ab0tj/dabao/README.md

# dabao

打包 (dǎ bāo or daa2 baau1), which means to take out (food) in Chinese, is a wireless, portable 36-key keyboard with a thumb trackpoint, designed for maximum flexibility and convenience.

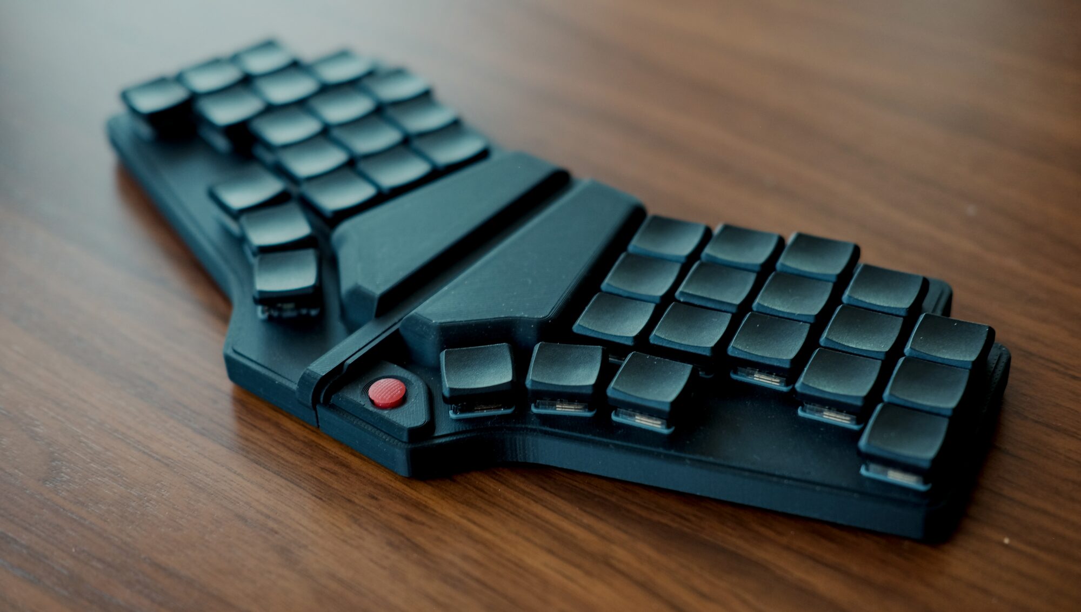
[picture p1: images/DSCF3942-web.jpg]
pcb as unibody
> 
> <sub>Keyboard can be used as a unibody...</sub>
>
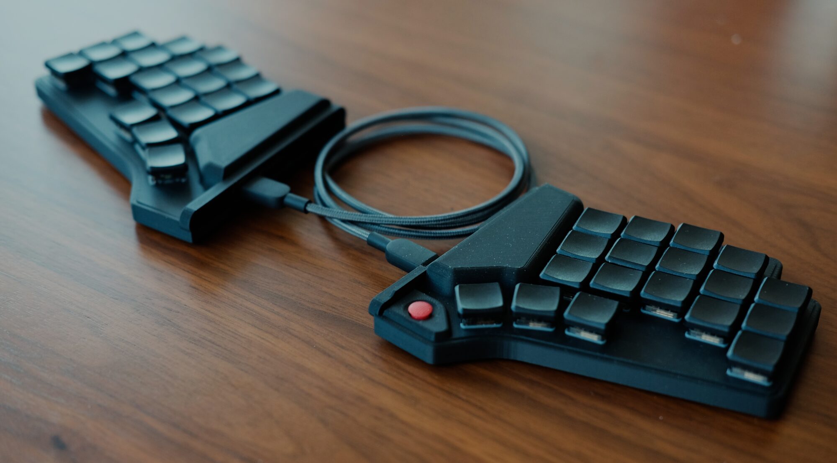
[picture p2: images/DSCF3957-web.jpg]
pcb as split
> 
> <sub>... or as a split!</sub>

## Design Rationale

I found that split keyboards can be cumbersome when I’m not working at a desk. Managing a laptop plus two independent keyboard halves while moving between coworking spaces, cafés, or even working from the couch quickly becomes unwieldy, and thus began the journey to create a keyboard for this specific need...

This project explores a keyboard that can seamlessly switch between a unibody form factor (easy to pick up and carry) and a fully split configuration when there's space for a full ergonomic setup. An integrated pointing device is included to reduce the need for external peripherals, making it truly portable.

Albeit unconventional, the trackpoint is positioned under the thumb to:

- Enable the use of hotswap sockets while keeping the overall keyboard height low
- Eliminate the need to modify keycaps for trackpoint clearance
- Allow the fingers to remain on the home row during pointing tasks

In practice, using the thumb instead of the index finger feels functionally similar. After a short adjustment period, I personally haven't experienced a meaningful loss in accuracy or precision.

## Features

- **Unibody or Split:** Unique magnetic 4-pin connector allows the keyboard to be used as a single unibody or split into two halves via a USB-C cable. Use unibody mode on the go, and split mode at your desk!
- **Single Microcontroller:** Uses one microcontroller and a GPIO expander, eliminating the need for two controllers or batteries to simplify charging and reduce costs.
- **Integrated Trackpoint:** For convenient and precise cursor control.
- **Reversible PCB:** Keeps ordering PCBs affordable.
- **Wireless via Bluetooth:** Wireless operation (between the host computer) for portability.
- **Hotswap Switches:** Supports Choc V1 or V2 switches. Can also be soldered directly if desired.
- **Thin:** The case measures a mere 8mm from top to bottom (excluding switches and keycaps), making it very portable.

## Case

The case was designed to be 3D printed with FDM in PLA or similar material, making it easy to print at home with consumer grade printers. Multi-material would be useful for cleaner removal of supports, but is not necessary. The case as shown was printed in Charcoal Black Matte PLA on a BambuLab P1S (no AMS).

See [here](./cad) for CAD files, and printing instructions [here](./docs/build-guide.md#case).

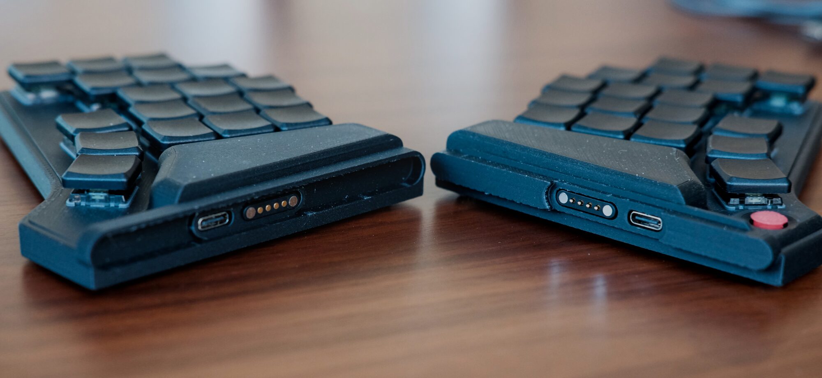
[picture p3: images/DSCF3886-web.jpg]


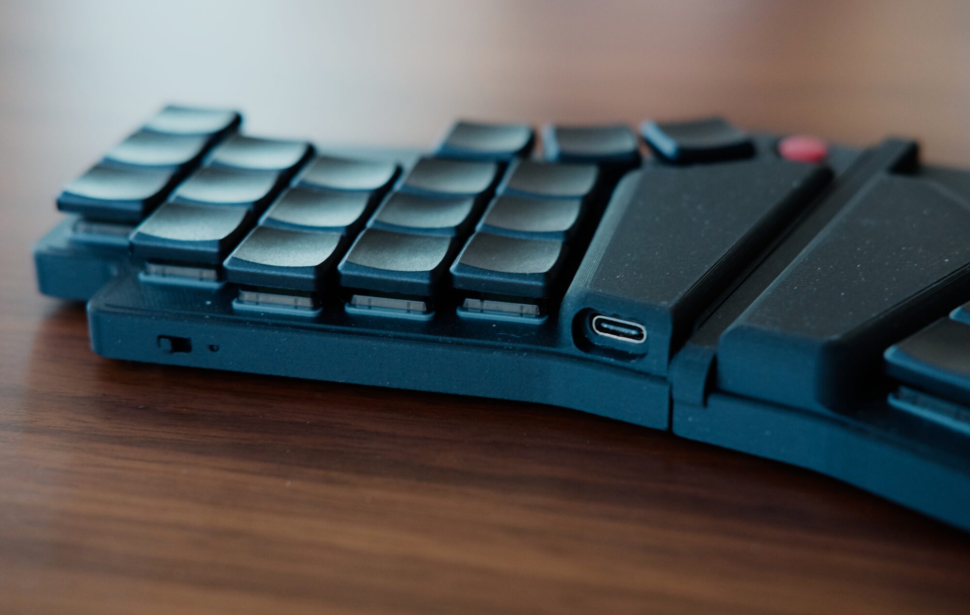
[picture p4: images/DSCF3946-web.jpg]


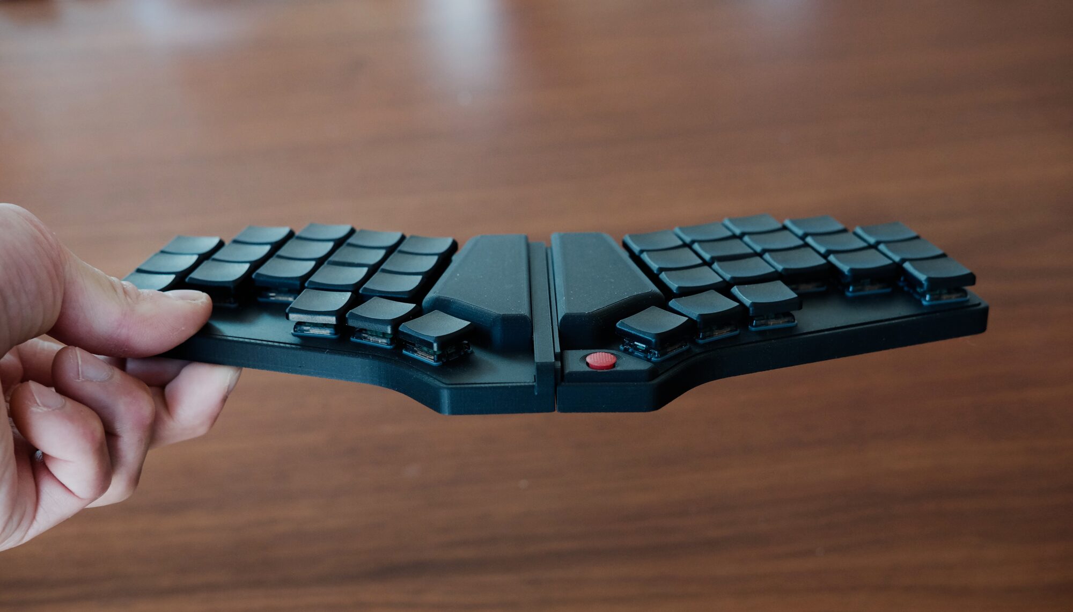
[picture p5: images/DSCF3984-web.jpg]


## Build Guide

> [!WARNING]
> This project is provided for educational and experimental purposes only. It is shared "as-is," without any warranty of any kind, express or implied, including but not limited to the warranties of merchantability or fitness for a particular purpose. By using these files, you acknowledge that you are assuming all risks associated with the assembly, use, and operation of the hardware. The author shall not be liable for any claim, damages, or other liability, whether in an action of contract, tort, or otherwise, arising from, out of, or in connection with the project or the use of these files.

See [Build Guide](./docs/build-guide.md) for instructions on how to build one for yourself!

## Firmware

See [zmk-config](https://github.com/justinmklam/zmk-config).

## Acknowledgements

This design was inspired by the following keyboards:

- [TPS42](https://github.com/crehmann/TPS42)
- [duet](https://github.com/zzeneg/duet)
- [Santoku](https://www.reddit.com/r/ErgoMechKeyboards/comments/oisnad/i_made_this_santoku_gen_2_trackpoint_as_a/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)

Helpful trackpoint resources:

- [infused-kim's Trackpoint Driver](https://github.com/infused-kim/kb_zmk_ps2_mouse_trackpoint_driver) - outdated for the recent versions of zmk, but still a treasure trove of information
- [Jorne Trackpoint Wiki](https://github.com/joric/jorne/wiki/Tracking)
- [TheMK Wiki - TrackPoint Overview](https://wiki.themk.org/index.php/TrackPoint)
- [KBD News - Trackpoint Integration Guide](https://kbd.news/How-to-integrate-a-trackpoint-into-your-keyboard-2447.html)
- [r/Trackpoint_Builders](https://www.reddit.com/r/TrackPoint_Builders/)
- [Trackpoint Builders Discord](https://discord.gg/48gM4jZkW)

## Support

Thank you to my sponsors for making this project possible!

The PCBs for this project were manufactured by **[PCBWay](https://pcbway.com)**. The boards came out clean with good tolerances and had a fast turnaround, especially considering it came from the other side of the world. Recommended if you're looking to prototype or build your own keyboard!
