ab0tj/dabao/docs/images/pasted-image-20261012104052.png

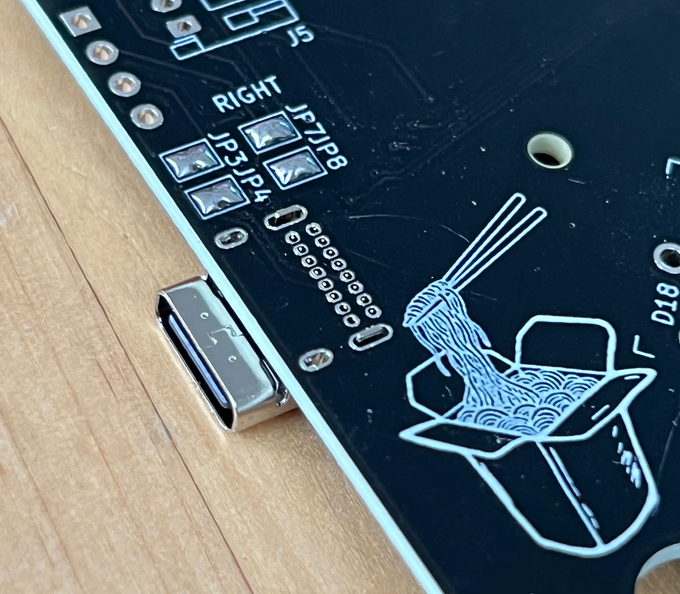
docs/images/pasted-image-20261012104052.png
