ab0tj/dabao/docs/images/pasted-image-20261012104239.png

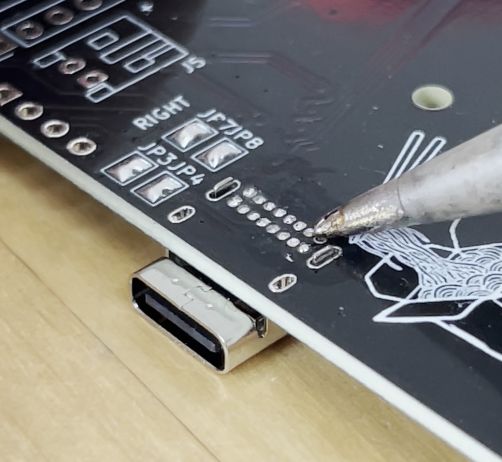
docs/images/pasted-image-20261012104239.png
