ab0tj/dabao/cad/3dprint/Right Bottom.stl

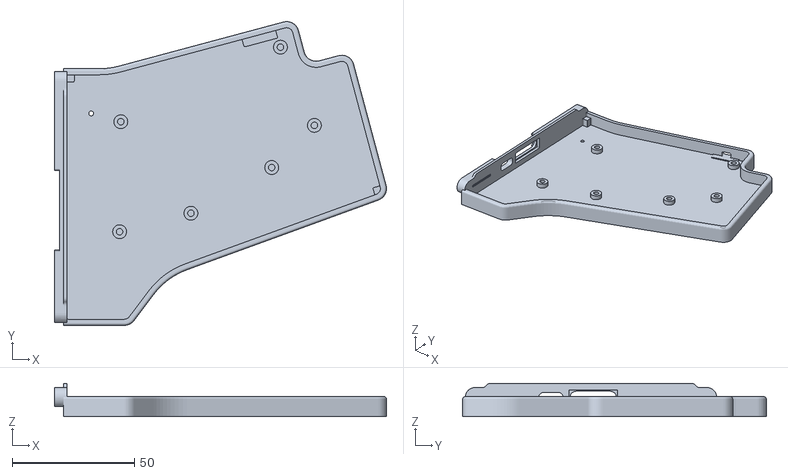
[picture p9: CAD file, 2026-10-15]
cad/3dprint/Right Bottom.stl
135.8 x 124.2 x 13.7
