ab0tj/dabao/cad/case.step

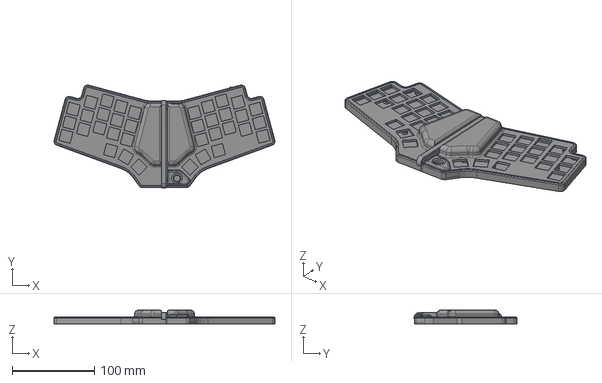
[picture p10: CAD file, 2026-10-15]
cad/case.step
268.1 x 124.9 x 17.0 mm
