ab0tj/dabao/cad/dabao.step

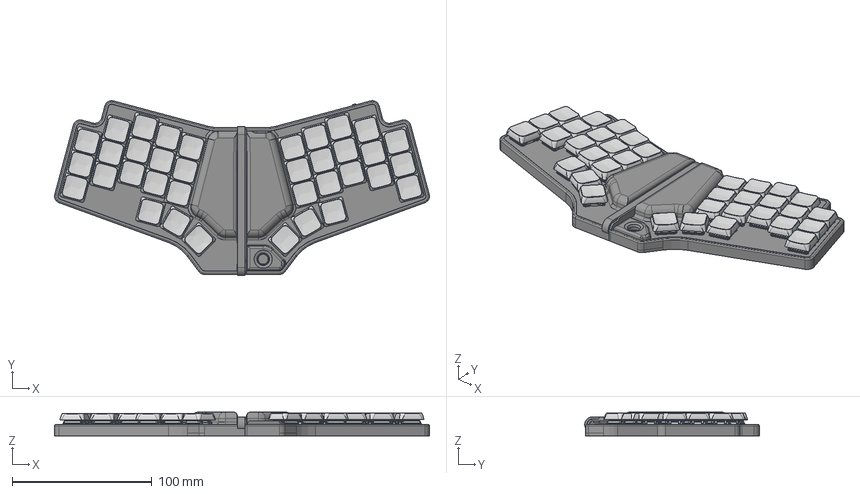
[picture p12: CAD file, 2026-10-15]
cad/dabao.step
268.1 x 124.9 x 17.0 mm
