ab0tj/dabao/cad/3dprint/Right Top.stl

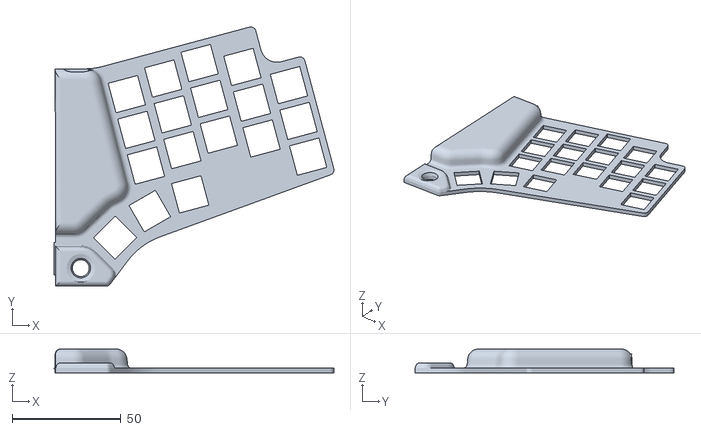
[picture p13: CAD file, 2026-10-15]
cad/3dprint/Right Top.stl
128.6 x 119.0 x 11.0
