ab0tj/dabao/cad/3dprint/Left Bottom.stl

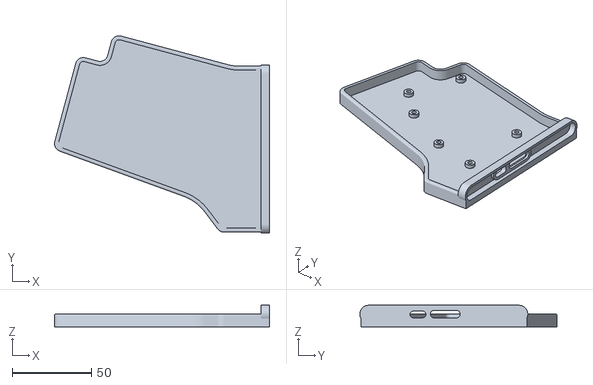
[picture p14: CAD file, 2026-10-15]
cad/3dprint/Left Bottom.stl
136.0 x 124.9 x 13.7
