ab0tj/dabao/cad/3dprint/Power Switch.stl

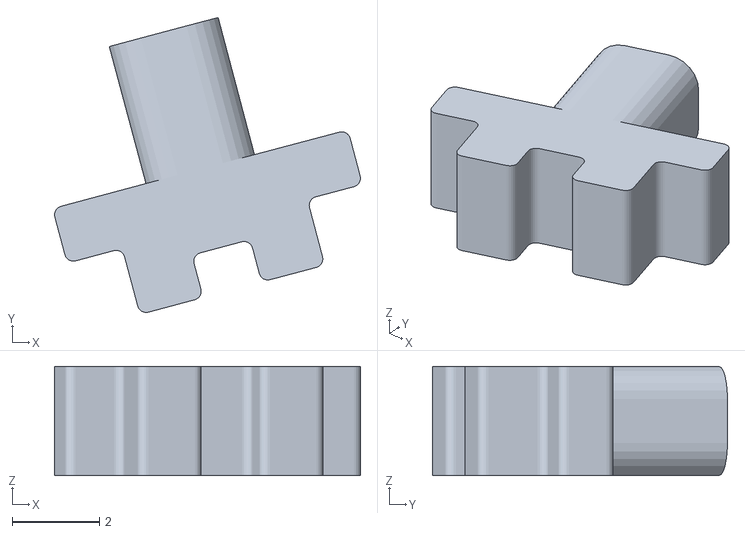
[picture p15: CAD file, 2026-10-15]
cad/3dprint/Power Switch.stl
7.01 x 6.76 x 2.50
