ab0tj/dabao/cad/3dprint/Trackpoint Stem Multi.stl

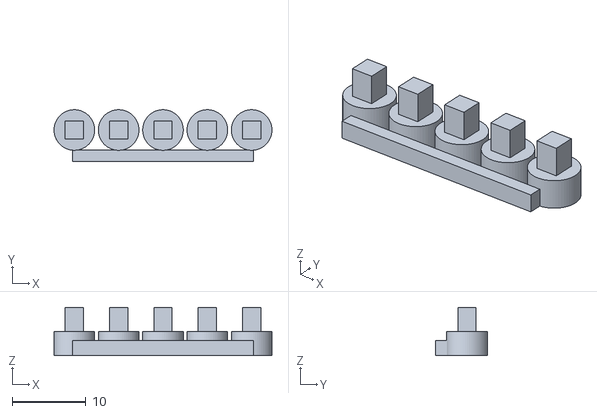
[picture p16: CAD file, 2026-10-15]
cad/3dprint/Trackpoint Stem Multi.stl
29.5 x 6.98 x 6.50
