ab0tj/dabao/pcb/dabao/dabao.kicad_pcb

## KiCad design pcb/dabao/dabao.kicad_pcb (2026-10-16)

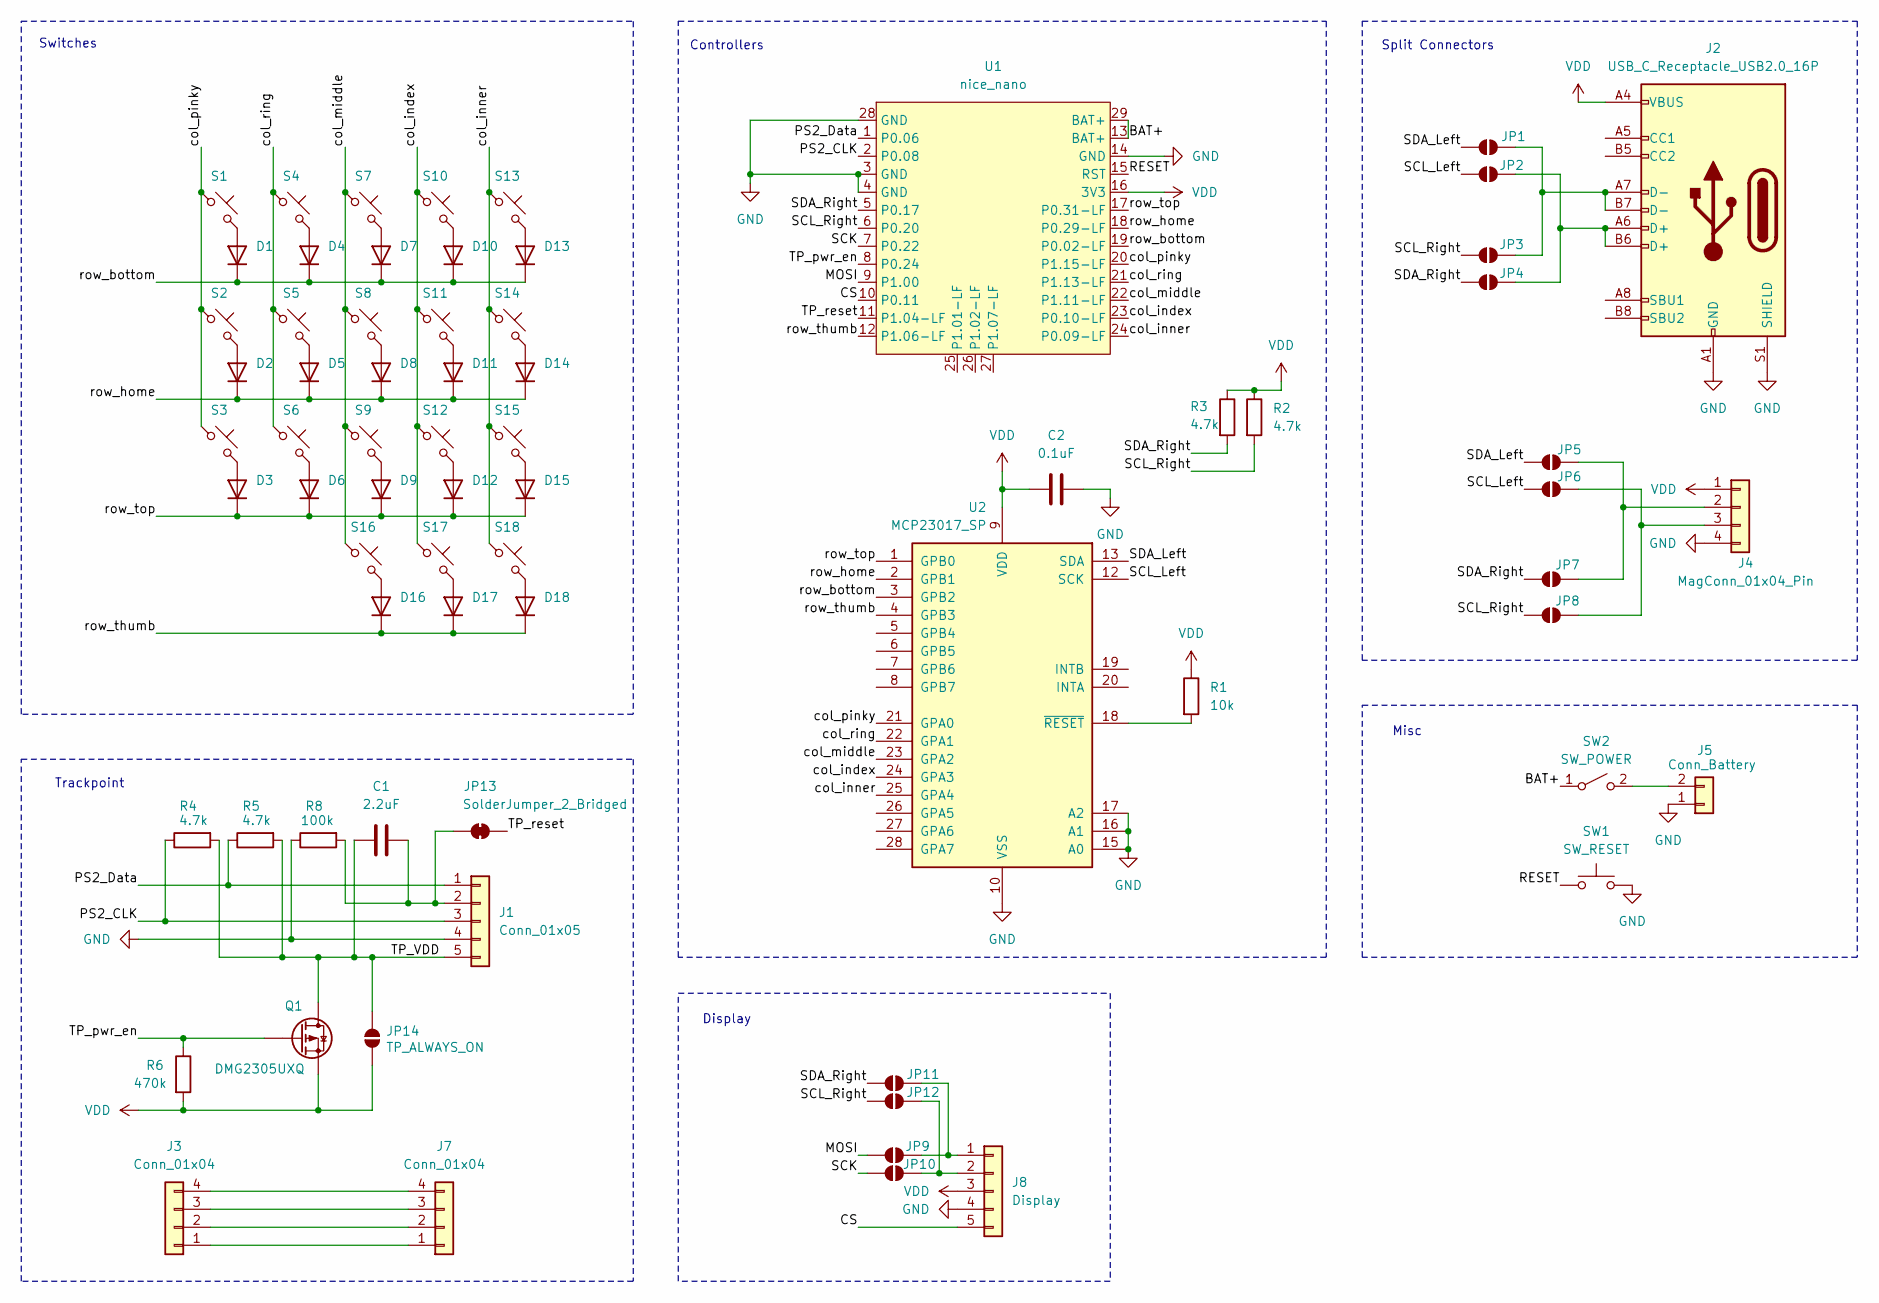
[picture p44: schematic dabao.kicad_sch]

Parts:
C1: 2.2uF; C_0805_2012Metric
C2: 0.1uF; C_0805_2012Metric
D1, D2, D3, D4, D5, D6, D7, D8, D9, D10, D11, D12, D13, D14, D15, D16, D17, D18: 1N4148; D_SOD-323_HandSoldering_Reversable
J1: Conn_01x05; TPModule
J2: USB_C_Receptacle_USB2.0_16P; USB_C_Receptacle_GCT_USB4085
J3, J7: Conn_01x04; TPSensorModule_Connector
J4: MagConn_01x04_Pin; PinMagnetic_1x04_P2.54mm
J5: Conn_Battery; JST_PH_S2B-PH-K_1x02_P2.00mm_Horizontal
J8: Display; PinHeader_1x05_P2.54mm_Vertical
JP1, JP2, JP3, JP4, JP5, JP6, JP7, JP8, JP9, JP10, JP11, JP12: SolderJumper_2_Open; SolderJumper-2_P1.3mm_Open_TrianglePad1.0x1.5mm
JP13: SolderJumper_2_Bridged; SolderJumper-2_P1.3mm_Bridged_Pad1.0x1.5mm
JP14: TP_ALWAYS_ON; SolderJumper-2_P1.3mm_Open_TrianglePad1.0x1.5mm
Q1: DMG2305UXQ
R1: 10k; R_0805_2012Metric
R2, R3, R4, R5: 4.7k; R_0805_2012Metric
R6: 470k; R_0805_2012Metric
R8: 100k; R_0805_2012Metric
S1, S2, S3, S4, S5, S6, S7, S8, S9, S10, S11, S12, S13, S14, S15, S16, S17, S18: choc_v1_SW_HS; Kailh_socket_PG1350_optional_reversible.kicad_mod
SW1: SW_RESET; SW_Push_SPST_NO_Alps_SKRK
SW2: SW_POWER; SW_MSK12C02-HB
U1: nice_nano; nice_nano_AH_USBup
U2: MCP23017_SP; SOIC-28W_7.5x17.9mm_P1.27mm

Connections:
/BAT+: SW2.1 (A), U1.13 (BAT+), U1.29 (BAT+)
/CS: J8.5, U1.10 (P0.11)
/MOSI: JP9.1 (A), U1.9 (P1.00)
/PS2_CLK: J1.3, R4.1, U1.2 (P0.08)
/PS2_Data: J1.1, R5.1, U1.1 (P0.06)
/RESET: SW1.1, U1.15 (RST)
/SCK: JP10.1 (A), U1.7 (P0.22)
/SCL_Left: JP2.1 (A), JP6.1 (A), U2.12 (SCK)
/SCL_Right: JP3.1 (A), JP8.1 (A), JP12.1 (A), R2.2, U1.6 (P0.20)
/SDA_Left: JP1.1 (A), JP5.1 (A), U2.13 (SDA)
/SDA_Right: JP4.1 (A), JP7.1 (A), JP11.1 (A), R3.2, U1.5 (P0.17)
/TP_VDD: C1.1, J1.5, JP14.2 (B), Q1.D, R4.2, R5.2
/TP_pwr_en: Q1.G, R6.1, U1.8 (P0.24)
/TP_reset: JP13.2 (B), U1.11 (P1.04-LF)
/col_index: S10.1, S11.1, S12.1, S17.1, U1.23 (P0.10-LF), U2.24 (GPA3)
/col_inner: S13.1, S14.1, S15.1, S18.1, U1.24 (P0.09-LF), U2.25 (GPA4)
/col_middle: S7.1, S8.1, S9.1, S16.1, U1.22 (P1.11-LF), U2.23 (GPA2)
/col_pinky: S1.1, S2.1, S3.1, U1.20 (P1.15-LF), U2.21 (GPA0)
/col_ring: S4.1, S5.1, S6.1, U1.21 (P1.13-LF), U2.22 (GPA1)
/row_bottom: D1.1 (K), D4.1 (K), D7.1 (K), D10.1 (K), D13.1 (K), U1.19 (P0.02-LF), U2.3 (GPB2)
/row_home: D2.1 (K), D5.1 (K), D8.1 (K), D11.1 (K), D14.1 (K), U1.18 (P0.29-LF), U2.2 (GPB1)
/row_thumb: D16.1 (K), D17.1 (K), D18.1 (K), U1.12 (P1.06-LF), U2.4 (GPB3)
/row_top: D3.1 (K), D6.1 (K), D9.1 (K), D12.1 (K), D15.1 (K), U1.17 (P0.31-LF), U2.1 (GPB0)
GND: C2.2, J1.4, J2.A1 (GND), J2.A12 (GND), J2.B1 (GND), J2.B12 (GND), J2.S1 (SHIELD), J4.4, J5.1, J8.4, R8.1, SW1.2, U1.3 (GND), U1.4 (GND), U1.14 (GND), U1.28 (GND), U2.10 (VSS), U2.15 (A0), U2.16 (A1), U2.17 (A2)
unnamed: D1.2 (A), S1.2
unnamed: D2.2 (A), S2.2
unnamed: D3.2 (A), S3.2
unnamed: D4.2 (A), S4.2
unnamed: D5.2 (A), S5.2
unnamed: D6.2 (A), S6.2
unnamed: D7.2 (A), S7.2
unnamed: D8.2 (A), S8.2
unnamed: D9.2 (A), S9.2
unnamed: D10.2 (A), S10.2
unnamed: D11.2 (A), S11.2
unnamed: D12.2 (A), S12.2
unnamed: D13.2 (A), S13.2
unnamed: D14.2 (A), S14.2
unnamed: D15.2 (A), S15.2
unnamed: D16.2 (A), S16.2
unnamed: D17.2 (A), S17.2
unnamed: D18.2 (A), S18.2
unnamed: C1.2, J1.2, JP13.1 (A), R8.2
unnamed: J3.1, J7.1
unnamed: J3.2, J7.2
unnamed: J3.3, J7.3
unnamed: J3.4, J7.4
unnamed: J4.2, JP5.2 (B), JP7.2 (B)
unnamed: J4.3, JP6.2 (B), JP8.2 (B)
unnamed: J5.2, SW2.2 (B)
unnamed: J8.1, JP9.2 (B), JP11.2 (B)
unnamed: J8.2, JP10.2 (B), JP12.2 (B)
unnamed: J2.A7 (D-), J2.B7 (D-), JP1.2 (B), JP3.2 (B)
unnamed: J2.A6 (D+), J2.B6 (D+), JP2.2 (B), JP4.2 (B)
unnamed: R1.2, U2.18 (~RESET)
VDD: C2.1, J2.A4 (VBUS), J2.A9 (VBUS), J2.B4 (VBUS), J2.B9 (VBUS), J4.1, J8.3, JP14.1 (A), Q1.S, R1.1, R2.1, R3.1, R6.2, U1.16 (3V3), U2.9 (VDD)

Notes on the sheet:
Misc
Display
Trackpoint
Split Connectors
Controllers
Switches

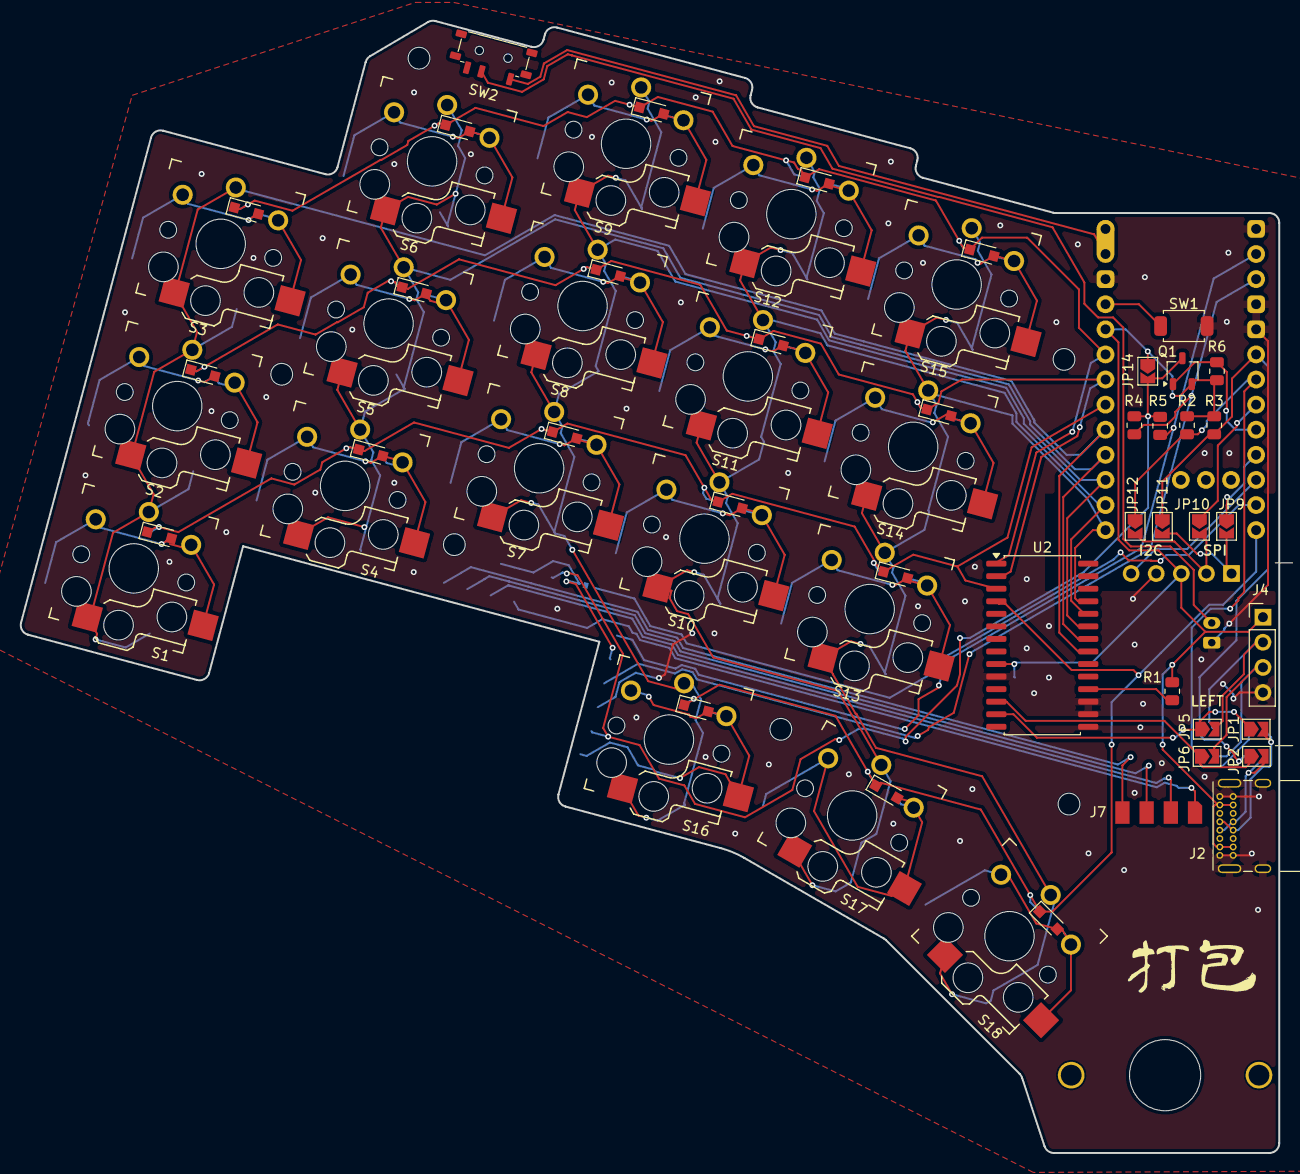
[picture p45: board dabao.kicad_pcb from above]

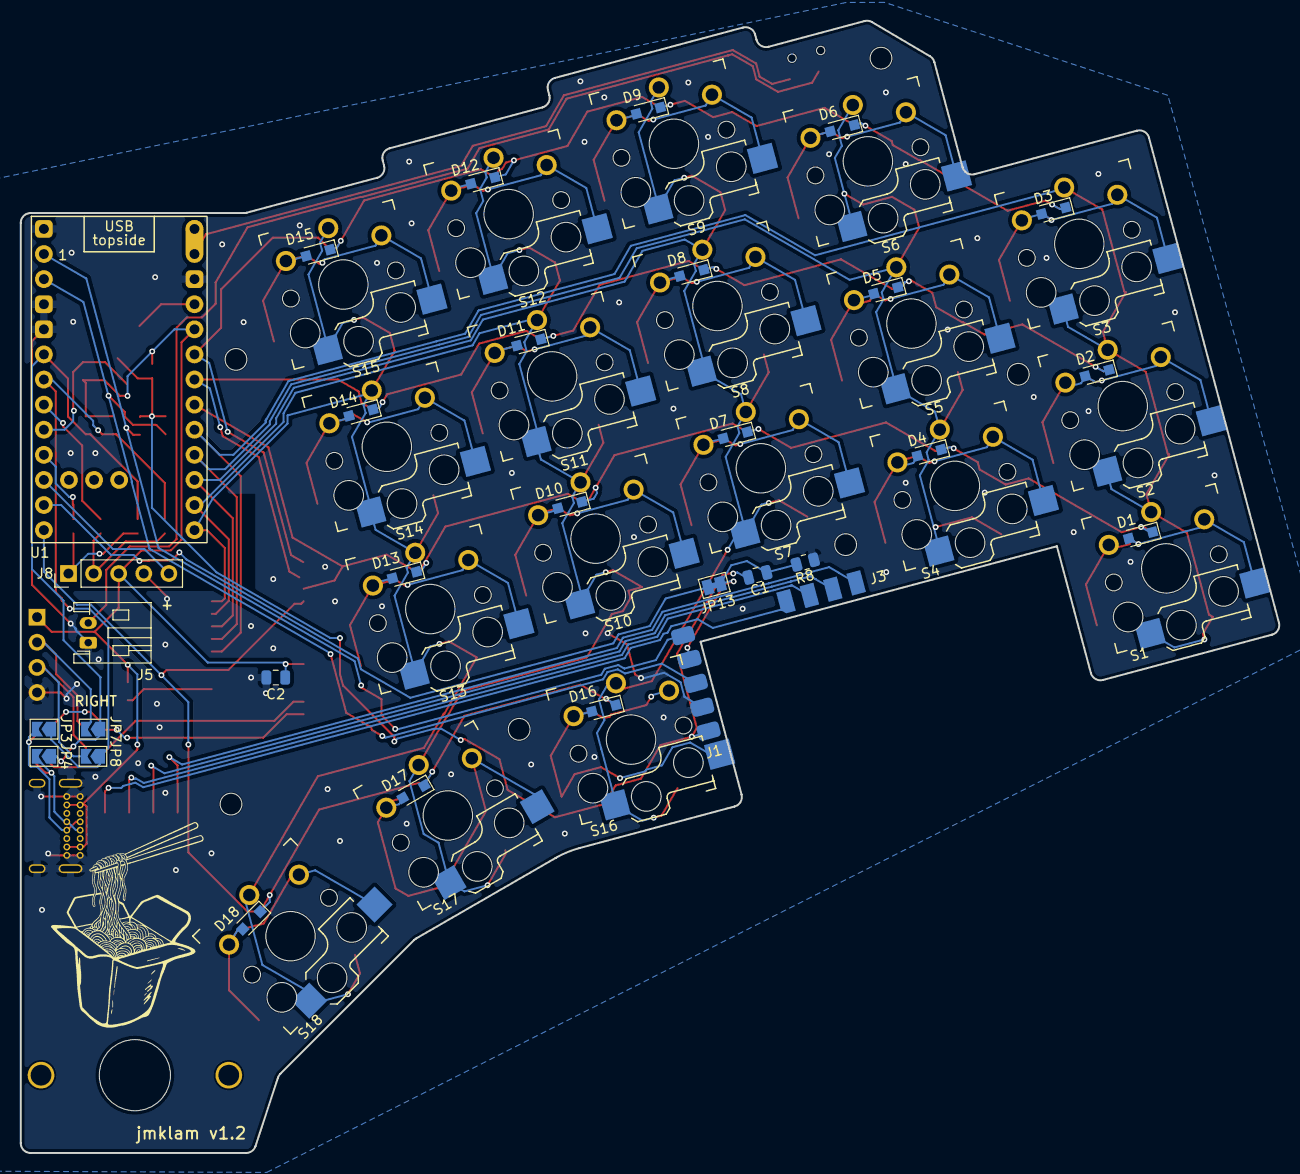
[picture p46: board dabao.kicad_pcb from below]

Board: 2 copper layers, 127.4 x 114.6 mm, 71 parts (49 on the bottom side), 56 nets.
