ab0tj/dabao/(commit log)

2026-10-15 Add docs, build guide, and case files
    [Left Bottom.stl, Left Top.stl, Power Switch.stl, Right Bottom.stl, Trackpoint Stem Multi.stl, case.step, dabao.3mf, dabao.step]
2026-10-15 Update 3d models
    [Left Bottom.stl, Left Top.stl, Power Switch.stl, Right Bottom.stl, Right Top.stl, case.step, dabao.3mf, dabao.step]
2026-10-16 Touchpoint power MOSFET, decoupling cap for GPIO expander
    [dabao.kicad_pcb, dabao.kicad_sch]
2026-10-16 Increase the value of R6 to reduce power draw when touchpoint is enabled
    [dabao.kicad_sch]
2026-10-16 Oops, not all the files were reflecting the R6 value change
    [dabao.kicad_pcb]
